ojoaustral/cehum-humedata_CC/cehum-humedata_CC-main/README.md

This subfolder contains selected device-specific firmware that may be more current than the corresponding files in the root directory — users looking for deployment-ready source code for individual buoys should inspect this forlder carefully. Substantial curatorial work remains to consolidate both locations into a coherent structure.
