ojoaustral/cehum-humedata_CC/Humedata-software/README.md

## Humedata software

En esta carpeta se encuentran todos los elementos necesarios del Humedata-software creados durante el curso PUC-CAPSTONE 2024. Esto incluye:

* El código fuente
* Manual de lanzamiento

Actualmente hay un test público subido en vercel de la aplicación web Humedat@.
* [Frontend](https://test-humedata-frontend.vercel.app)
* [Backend](https://y48fprn6r7.us-east-2.awsapprunner.com)

Existen dos videos demostrativos de la aplicación web y la aplicación móvil en funcionamiento.
