ojoaustral/cehum-humedata_CC/Humedata-software/screenshots/Screenshot 2026-05-22 130528.png

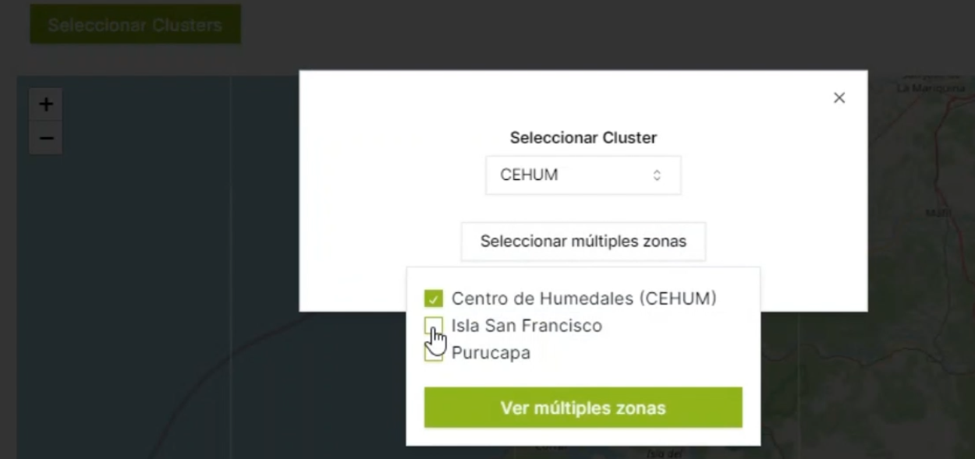
Humedata-software/screenshots/Screenshot 2026-05-22 130528.png
