ojoaustral/cehum-humedata_CC/Humedata-software/screenshots/Screenshot 2026-05-22 130754.png

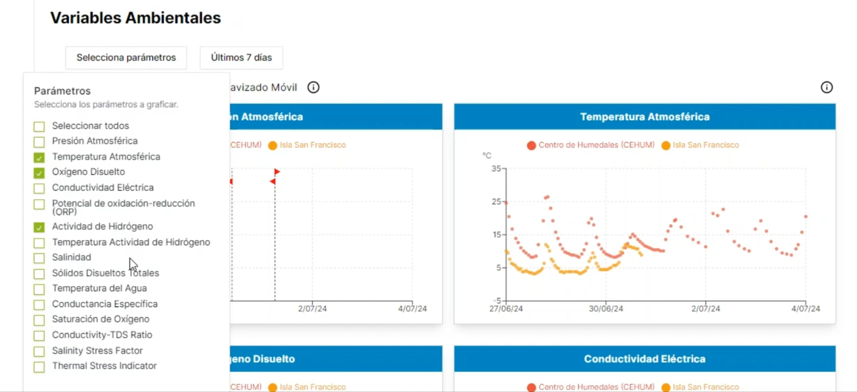
Humedata-software/screenshots/Screenshot 2026-05-22 130754.png
