ojoaustral/cehum-humedata_CC/Humedata-software/screenshots/Screenshot 2026-05-22 131120.png

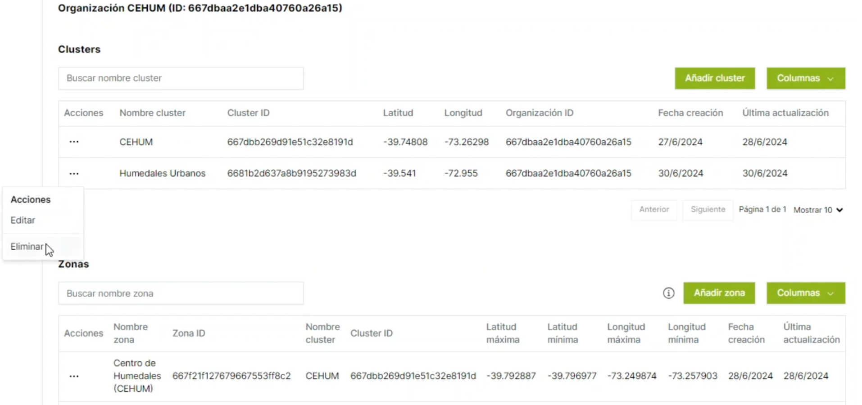
Humedata-software/screenshots/Screenshot 2026-05-22 131120.png
