ojoaustral/cehum-humedata_CC/Humedata-software/screenshots/Screenshot 2026-05-22 131601.png

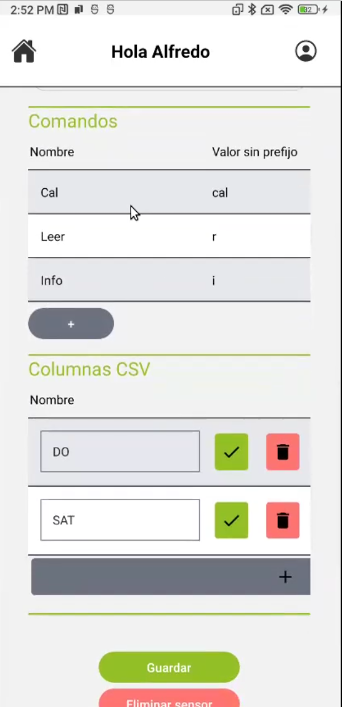
Humedata-software/screenshots/Screenshot 2026-05-22 131601.png
