ojoaustral/cehum-humedata_CC/opencloud_server/grafana/img/Humedata20230926small.jpg

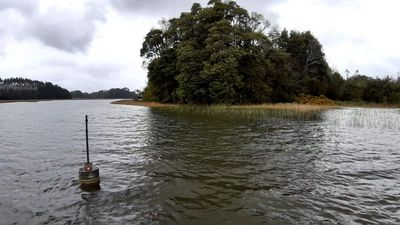
opencloud_server/grafana/img/Humedata20230926small.jpg
