ojoaustral/cehum-humedata_CC/opencloud_server/grafana/img/Humedata_20221118_165704.jpg

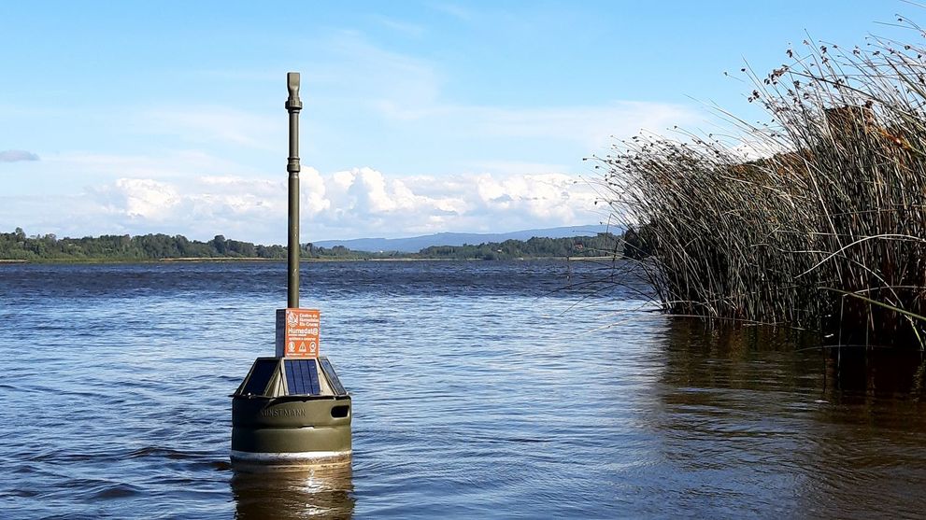
opencloud_server/grafana/img/Humedata_20221118_165704.jpg
