ojoaustral/cehum-humedata_CC/cehum-humedata_CC-main/xian_gps_debug/xian_gps_debug_NeoGPS/xian_gps_debug_NeoGPS.ino

#include <NMEAGPS.h>

// 

/*
The following script was implemented by C. Correa on 2023-03-03 to find a more robust and reliable way to gat a timestamp from the GPS module of Humedata.
The previous version uses TinyGPS++ but both HD Atlas and Lihuen produced faulty and erratic timestamps.   
 
Good documentation here https://github.com/SlashDevin/NeoGPS/blob/master/README.md

NEO-6M GPS Module with Arduino:
https://randomnerdtutorials.com/guide-to-neo-6m-gps-module-with-arduino/

Position Fix LED Indicator
There is an LED on the NEO-6M GPS module that indicates the status of the ‘Position Fix’. It will blink at different rates depending on which state it is in:

No blinking – it is searching for satellites.
Blink every 1s – Position Fix is found (the module can see enough satellites).
*/

// Set up the syste to read the GPS module using the Arduino of the Humedata Lihuen V.1.0. 

const int XIAN_SWITCH = A4;
const int GPS_SWITCH = A5;
const int RS485_SWITCH = A6;
const int MAX_3485_EN = 3;

// Define GPS port
#define gpsPort Serial1
#define GPS_PORT_NAME "Serial1"
#define DEBUG_PORT Serial


void setup()
{
  pinMode(XIAN_SWITCH, OUTPUT);
  pinMode(GPS_SWITCH, OUTPUT);
  pinMode(RS485_SWITCH, OUTPUT);
  pinMode(MAX_3485_EN, OUTPUT);

  digitalWrite(GPS_SWITCH, HIGH);
  digitalWrite(XIAN_SWITCH, LOW);
  digitalWrite(RS485_SWITCH, LOW);
  digitalWrite(MAX_3485_EN, LOW);

  
  Serial.begin(115200);
  Serial1.begin(9600);
}

// Using the NeoGPS library, define a Neo object
NMEAGPS gps;

// The main NMEAGPS gps; object you declare in your sketch parses received characters, gradually assembling a fix (e.g., gps_fix fix;).
gps_fix currentFix;

float gps_latitude;
float gps_longitude;

int _year;
int _month;
int _date;
int _hour;
int _minutes;
int _seconds;

void loop()
{
  // This sketch displays information every time a new sentence is correctly encoded.
  while (gps.available( Serial1 )) {
    currentFix = gps.read();
if (currentFix.valid.date) {
    Serial.println( "We have date!" );
    Serial.print( currentFix.dateTime.year);
    Serial.print( '-' );
    Serial.print( currentFix.dateTime.month);
    Serial.print( '-' );
    Serial.println( currentFix.dateTime.date);
    _year = currentFix.dateTime.year;
    _month = currentFix.dateTime.month;
    _date = currentFix.dateTime.date;
    }
  else{
  Serial.println(F("No date yet, sorry."));
    //_year = 66;
    //_month = 6;
    //_date = 6;
    
    //while(true);
  }
if (currentFix.valid.time) {
    Serial.println( "We have time!" );
    Serial.print( currentFix.dateTime.hours );
    Serial.print( ':' );
    Serial.print( currentFix.dateTime.minutes );
    Serial.print( ':' );
    Serial.println( currentFix.dateTime.seconds );
  }
  else{
  Serial.println(F("No time yet, sorry."));
    //while(true);
    }
if (currentFix.valid.location) {
    Serial.println( "We have Lat/Lon!" );
    Serial.print( currentFix.latitude() );
    Serial.print( ',' );
    Serial.println( currentFix.longitude() );
    gps_latitude = currentFix.latitude();
    gps_longitude = currentFix.longitude();
  }
  else{
  Serial.println(F("No GPS location yet, sorry."));
   // gps_latitude = 99;
    //gps_longitude = 99;
    //while(true);
    }

    Serial.print( "Stored coordenates: Lat" ); Serial.print( gps_latitude );Serial.print( ", Lon"); Serial.println( gps_longitude );
    Serial.print( "Stored date: " );
    Serial.print( _year ); Serial.print( "-" ); Serial.print( _month ); Serial.print( "-" ); Serial.println( _date );
  
  }
    /*Serial.print( "Stored coordenates: Lat" ); Serial.print( gps_latitude );Serial.print( ", Lon"); Serial.println( gps_longitude );
    Serial.print( "Stored date: " );
    Serial.print( _year ); Serial.print( "-" ); Serial.print( _month ); Serial.print( "-" ); Serial.println( _date );
    */
delay(3000); // a delay just to slow down the display 

}
