ojoaustral/cehum-humedata_CC/Humedata-software/2024-1-S1-Grupo1-main/packages/arduino/CommandDispatcher.h

#ifndef COMMAND_DISPATCHER_H
#define COMMAND_DISPATCHER_H

#include <Arduino.h>

typedef void (*CommandHandler)(const char* command, char* response, int* responseCode);

struct CommandMapping {
    String commandPrefix;
    CommandHandler handler;
};

void registerCommandHandler(const String& commandPrefix, CommandHandler handler);
void processCommand(const char* command);

#endif
