ojoaustral/cehum-humedata_CC/Humedata-software/2024-1-S1-Grupo1-main/packages/arduino/Serial.ino

#include "CommandDispatcher.h"

void setupSerial() {
  Serial.begin(9600);
}

void loopSerial() {
  if (Serial.available() > 0) {
    String data = Serial.readStringUntil('\n');
    processCommand(data.c_str());
  }
}
