ojoaustral/cehum-humedata_CC/cehum-humedata_CC-main/humedata_xian_for_lihuen/libs.h

#include <Wire.h>
#include <Arduino_MKRENV.h>
#include <SPI.h>
#include <SD.h>
#include <MKRWAN.h>
#include <Adafruit_BMP280.h>
#include <RTClib.h>
#include <DS3232RTC.h>     
#include <TimeLib.h>
#include "Arduino.h"
#include "ArduinoLowPower.h"
#include "TinyGPS++.h"
#include "io.h"
#include "vars.h"
#include "int.h"
#include "wtr.h"
#include "atm.h"
