ojoaustral/cehum-humedata_CC/cehum-humedata_CC-main/humedata_xian_for_lihuen/vars.h

// Datos LoRaWAN para el acceso a la red de los dispositivos
LoRaModem modem;
String devEUI = "A8610A3233298409";                  // --> LIHUEN
// String devEUI = "A8610A3237277009";               // --> ATLAS 
//String devEUI =  "A8610A3237267209";               // --> XI'AN
String devEUI = "A8610A32342C7210";                  // --> LIHUEN 2
String appEui = "70B3D57ED0042E7E";                  
String appKey = "1195AF29AFFE1665C5AF311B4DE62D5A";  // --> LIHUEN
String appKey = "F7DB16C58B3486AC3645C4D8035FADB1"; // --> LIHUEN 2
                    
uint8_t _data_lorawan[50];
  
// BMP280
Adafruit_BMP280 bmp;
float atm_pressure;
float atm_temperature;

// MKR ENV Shield
float internal_pressure = 0;
float internal_temperature = 0;
float internal_humidity = 0;
File dataFile;  
float sd_data[24];
const int _data_size = 24;
float _data[_data_size];

// Battery Level Reading
int batt_analog = 0;
float batt_voltage = 0.0;

//RTC DS3231
RTC_DS3231 rtc;
int _seconds, _minutes, _hour, _day, _month, _year,_rday;

// GPS 
TinyGPSPlus gps;
float gps_latitude = 0.0;
float gps_longitude = 0.0;
float gpslati = 0.0;
float gpslong = 0.0;
int result = 999; // figure out why I'm getting values where thre is none 
int cycle = 0;
float time_cycle = 4;
int on = 1;
// Christian ojo que el valor original de TinyGPS++ es double, supongo que float igual recibe un double aproximado  
byte gps_latitude_float_bytes[4];
byte gps_longitude_float_bytes[4];
byte gps_latitude_float_bytes16[3];
byte gps_longitude_float_bytes16[3];



// UART commands to request sensors values
byte request_ec[]   = {0x13, 0x03, 0x26, 0x00, 0x00, 0x05, 0x8d, 0xf3}; 
byte request_ph[]   = {0x01, 0x03, 0x28, 0x00, 0x00, 0x02, 0xcd, 0xab};
byte request_do[]   = {0x04, 0x03, 0x20, 0x00, 0x00, 0x06, 0xce, 0x5d};
byte request_orp[]  = {0x07, 0x03, 0x12, 0x00, 0x00, 0x02, 0xc1, 0x15};

// Buffer to store readings from sensors
byte ec_readings[50];
byte ph_readings[50];
byte do_readings[50];
byte orp_readings[50];
byte orp_float_bytes[2];

// Variables to store water readings
float ec_f    = 0.0;
float ph_f    = 0.0;
float ph_c    = 0.0;
float do_f    = 0.0;
float orp_f   = 0.0;
float temp_f  = 0.0;
float sat_f   = 0.0;
byte tds_float_bytes[4];
float tds     = 0;

int do_received = 0;
int ph_received = 0;
int ec_received = 0;
int orp_received = 0;

int reading_tries = 0;
