ojoaustral/cehum-humedata_CC/(commit log)

2023-03-04 Lihuen GPS module test script using NeoGPS lib.
    The following script was implemented by C. Correa on 2023-03-03 to find a more robust and reliable way to gat a timestamp from the GPS module of Humedata. The previous version tried TinyGPS++ lib (CS, Feb 2023) but both HD Atlas and Lihuen failed to produce reliable timestamps for storage in the SD memories.
    [xian_gps_debug_NeoGPS.ino]
2023-03-23 Battery level fixes
    A number of changes to enhance and store battery level information. Includes new parameterization based on empirical data to convert from analog readings to Volts. Made new variables, and renamed others to make the code more intuitive and complete. Correct Volts are now stored in the SD cards of both Atlas and Lihuen.
    [atm.h, humedata_atlas.ino, humedata_xian.ino, int.h, int_functions.ino, io_definitions.h, vars.h, xian_gps_debug_NeoGPS.ino]
2023-10-22 Battery voltage, TTN Payload formatters
    Lihuen: replaced analog battery level with calculated battery voltage from an empirical equation for LoRaWAN comm. Therefore the HDs now transmit and store in SD card the battery voltage.
    Also, setting sleep_time =1; gps_fix_time = 0; magically solved the DO shifting problem. Exploring interference with GPS or something else, remains pending.
    Also, created a new repository of TTN Payload formatters, one for each Humedata. The Payload formatter were modified reducing redundancy and editing battery level variable. Now voltage is calculated inside of HD, and volts ate transmitted through LoRaWAN.
    [humedata_xian.ino, int.h]
2023-10-22 Atlas Battery volts transmission and Payload formatter
    This update is similar to the one for Lihuen on the same subject. It was kept separate because the update is untested (HD Atlas is currently in the water). Update the device's internal code and the TTN payload with this commit as soon as you can.
2024-01-15 Voltage enhancement
    Enhanced precision of battery voltage LoRaWAN transmission. Voltage from empirical equation.
2024-10-11 Update RTC_set_time.ino
    Added an offset to system time at compilation to avoid having to enter date and time manually in the summer.
    [RTC_set_time.ino]
2024-12-23 añadido código de la página web (SIN REVISAR)
2025-01-03 reconfiguracion de sentry (test)
2025-01-03 Revert "reconfiguracion de sentry (test)"
    This reverts commit 427822e176ae07d882bd3047c73cdc3f0568b4c6.
2025-03-13 Cambio del comando copy:types en package.json para compatibilidad con windows
2025-03-17 Actualización del middleware en el frontend
2025-05-09 mini corrección manual de lanzamiento
2026-09-24 Document OpenCloud server as built; add 2026 backup record
    Add opencloud_server/: a complete record of the Humedat@ backend as it ran
    on the OpenCloud VM (2022-2026), checked against the live server on
    2026-09-24.
    - subscriber/: the MQTT -> MySQL scripts retrieved from the server (generic script plus the Atlas and BP per-device copies), with secrets replaced by placeholders
    - systemd/: the Atlas, BP and Lihuen units (small bugs fixed and
    commented), the retired Xian unit and a template for new buoys
    - db/: MySQL schema and the current device registry
    - grafana/: 7 dashboards (JSON), 102 annotations, logos, grafana.ini
    settings and the Grafana Agent config
    - README.md: architecture, data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
